crnicholson/Carbon-Capture/Sorbent Prep/README.md

# Sorbent Prep

This documentation outlines the process for sorbent preparation. This step is essential because the resin, as received from the factory, is not immediately ready for use. Out of the box, the functional groups on the resin are paired with chloride ions. For our purposes, we need to replace these chloride ions with either hydroxide or carbonate ions.

In this case, I’m opting to exchange the chloride ions for carbonate ions. This choice is partly for convenience, as handling hydroxide in a kitchen setting isn’t ideal.

For those with a background in chemistry, you can take this process a step further by analyzing the water collected from rinsing the resin after each wash. Using the Mohr method, you can determine how many chloride ions are being removed. However, since I’m working in a kitchen, I’m skipping this step.
