crnicholson/Carbon-Capture/tests/test-2-with-sorbent-1.md

# Test #2 with Sorbent #1

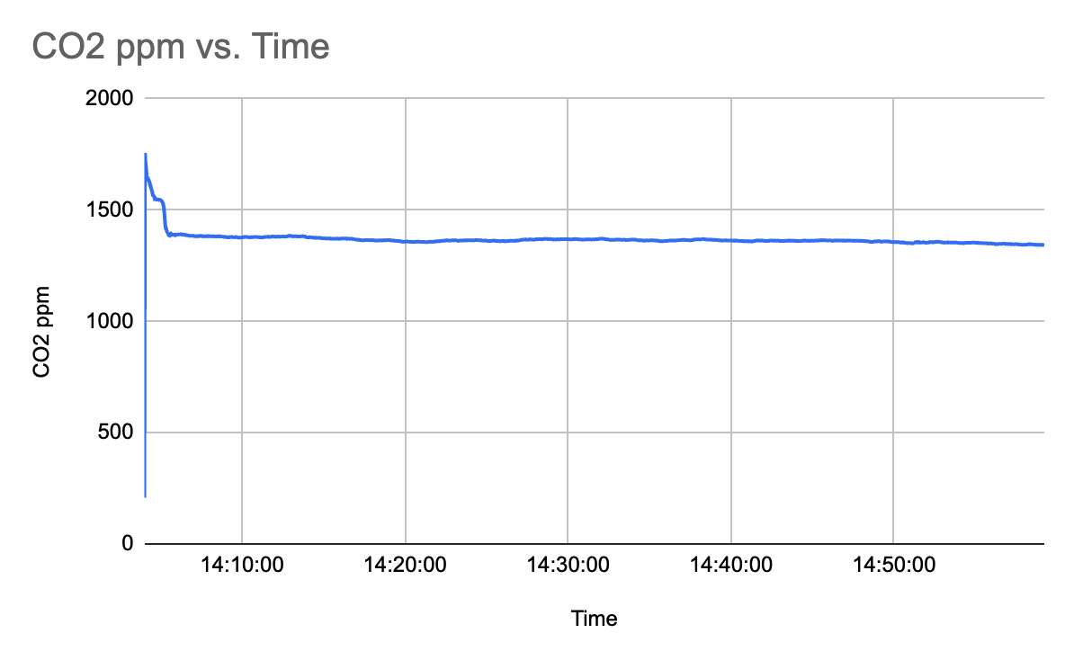
[picture p10: Media/Screenshot 2023-08-28 at 7.13.21 AM.png]


Notes: The CO₂ levels didn't change much when I added water. I really don't know why this happened. Maybe because the time frame was too short?

Time water added: unknown

Start ppm: unknown

End ppm: 1343 ppm

Rise ppm: unknown

Total time frame: 56 minutes

Experiment time frame: unknown

Test chamber: MK2
