crnicholson/Carbon-Capture/tests/test-3-with-sorbent-1.md

# Test #3 with Sorbent #1

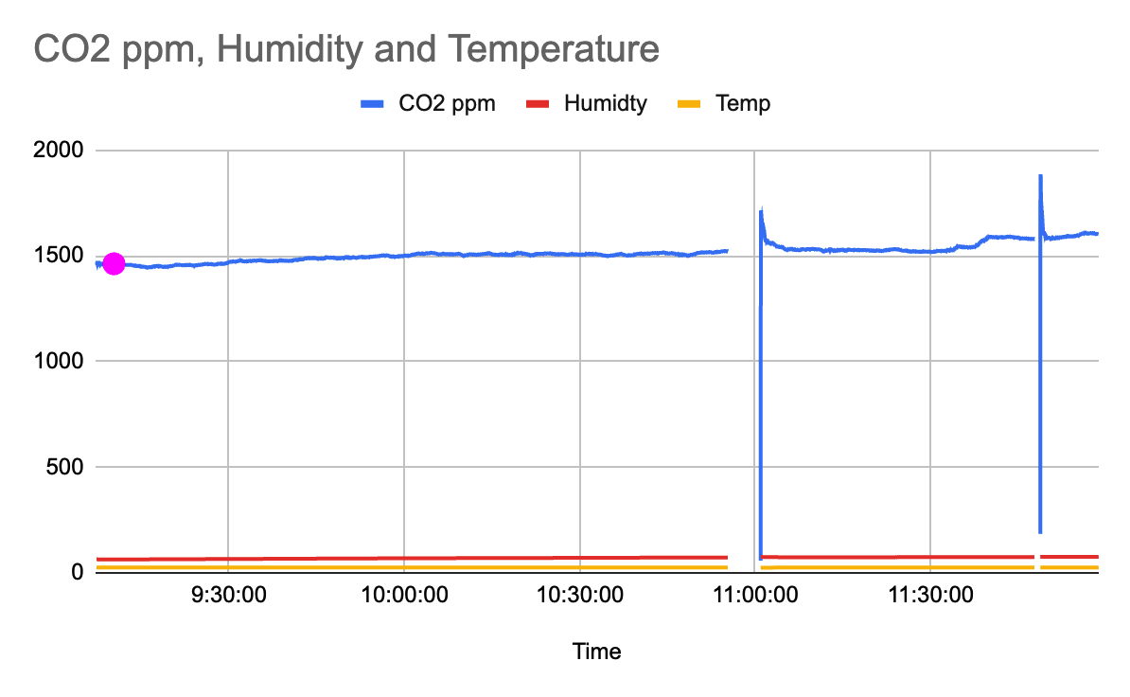
[picture p11: Media/image-5.png]


Notes: My first success! The ppm changed when I added water! I don't know why this didn't happen with my other tests. Maybe because the test was longer this time? These results aren't nearly as good as they should be, so I'll look into improving this experiment.

Time water added: 9:10

Start ppm: 1459

End ppm: 1603

Rise ppm: 144

Total time frame: 2hrs and 51 min

Experiment time frame: 2hrs and 48 min

Test chamber: MK2

Grams of CO₂ captured: 0.005124384
