crnicholson/Carbon-Capture/tests/test-1-with-sorbent-1.md

# Test #1 with Sorbent #1

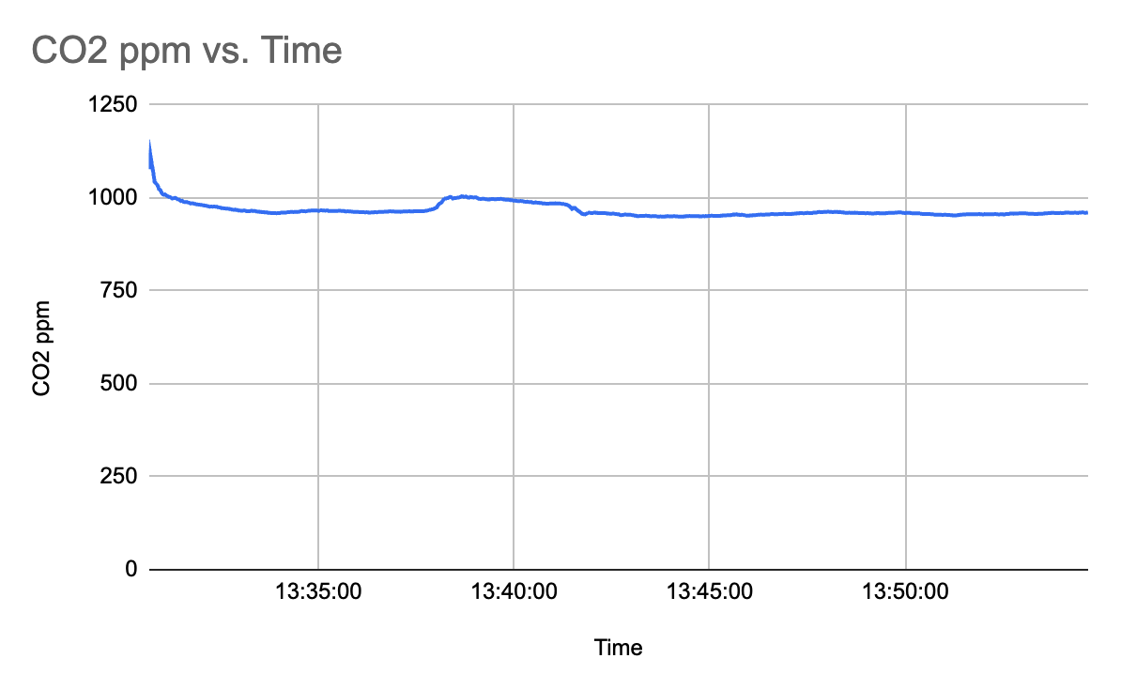
[picture p17: Media/Screenshot 2023-08-28 at 7.10.17 AM.png]


Notes: It didn't change much when I added water, or at all. I don't have much data to share here as this was my first time doing this. More data will be shared in the next posts.
